ziziccc/bus-arrival-system/docs/subsystem_flowchart.png

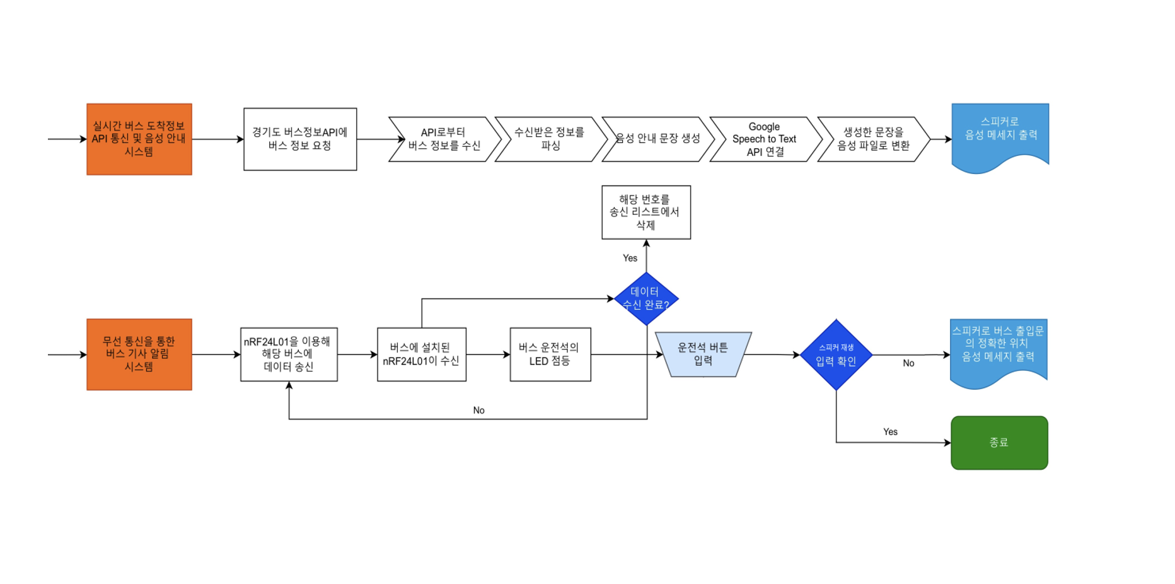
docs/subsystem_flowchart.png
