ziziccc/bus-arrival-system/docs/system_flowchart.png

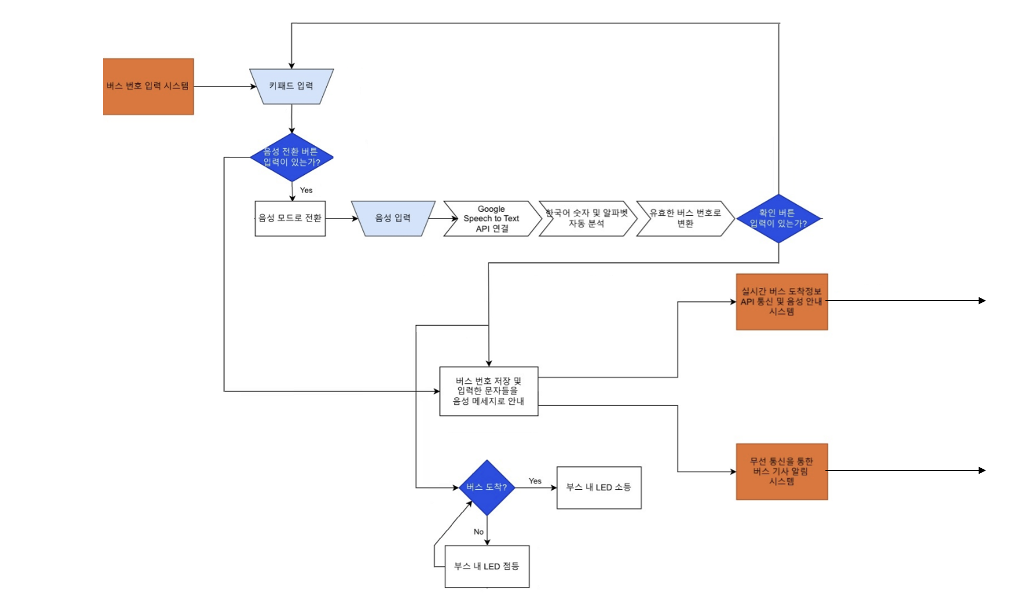
docs/system_flowchart.png
